dquadros/ch32v_piano/Imagens/Placa.png

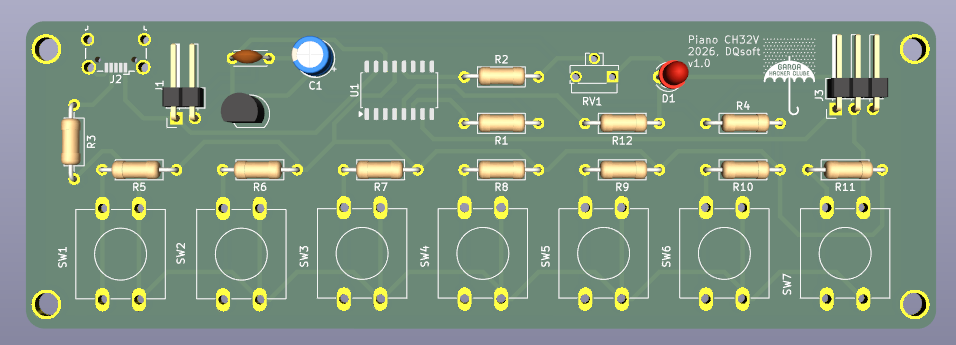
Imagens/Placa.png
