dquadros/ch32v_piano/hardware/PianoCH32V_sch.pdf

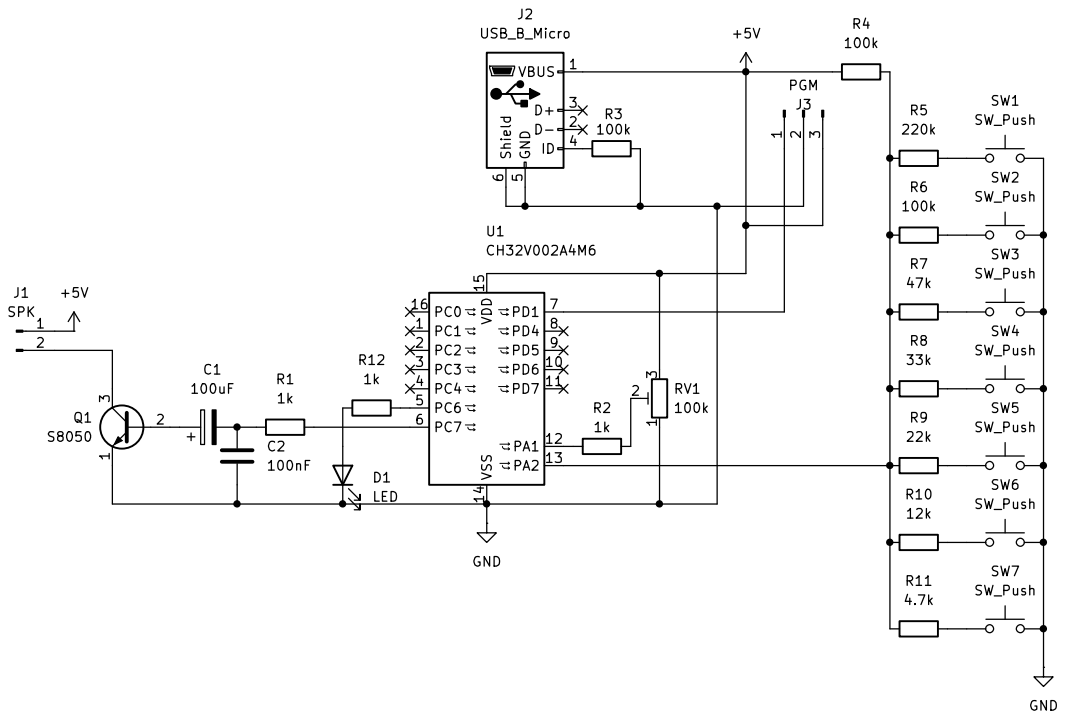
[picture p2: page 1]
