dquadros/ch32v_piano/hardware/PianoCH323V.kicad_pcb

## KiCad design hardware/PianoCH323V.kicad_pcb (2026-10-10)

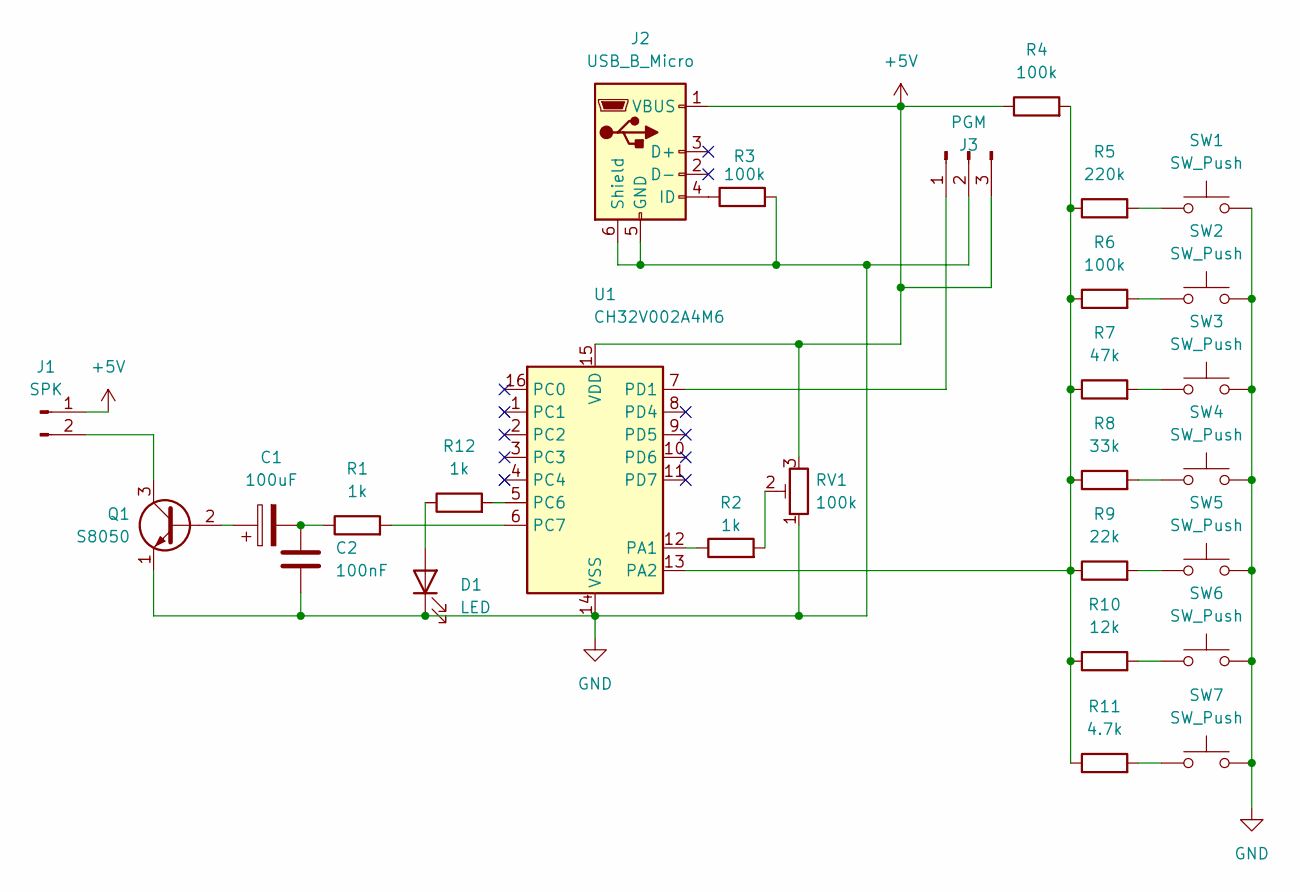
[picture p3: schematic PianoCH323V.kicad_sch]

Parts:
C1: 100uF; CP_Radial_D5.0mm_P2.50mm
C2: 100nF; C_Disc_D4.3mm_W1.9mm_P5.00mm
D1: LED; LED_D3.0mm
J1: SPK; PinHeader_1x02_P2.54mm_Horizontal
J2: USB_B_Micro; USB_Micro-B_Wuerth_629105150521_CircularHoles
J3: PGM; PinHeader_1x03_P2.54mm_Horizontal
Q1: S8050; TO-92_Inline
R1, R2, R12: 1k; R_Axial_DIN0207_L6.3mm_D2.5mm_P10.16mm_Horizontal
R3, R4, R6: 100k; R_Axial_DIN0207_L6.3mm_D2.5mm_P10.16mm_Horizontal
R5: 220k; R_Axial_DIN0207_L6.3mm_D2.5mm_P10.16mm_Horizontal
R7: 47k; R_Axial_DIN0207_L6.3mm_D2.5mm_P10.16mm_Horizontal
R8: 33k; R_Axial_DIN0207_L6.3mm_D2.5mm_P10.16mm_Horizontal
R9: 22k; R_Axial_DIN0207_L6.3mm_D2.5mm_P10.16mm_Horizontal
R10: 12k; R_Axial_DIN0207_L6.3mm_D2.5mm_P10.16mm_Horizontal
R11: 4.7k; R_Axial_DIN0207_L6.3mm_D2.5mm_P10.16mm_Horizontal
RV1: 100k; Potentiometer_Runtron_RM-063_Horizontal
SW1, SW2, SW3, SW4, SW5, SW6, SW7: SW_Push; SW_PUSH-12mm
U1: CH32V002A4M6; SOP-16_4.55x10.3mm_P1.27mm

Connections:
+5V: J1.1, J2.1 (VBUS), J3.3, R4.1, RV1.3, U1.15 (VDD)
GND: C2.2, D1.1 (K), J2.5 (GND), J2.6 (Shield), J3.2, Q1.1 (E), R3.2, RV1.1, SW1.2, SW2.2, SW3.2, SW4.2, SW5.2, SW6.2, SW7.2, U1.14 (VSS)
unnamed: C1.2, C2.1, R1.1
unnamed: D1.2 (A), R12.1
unnamed: J1.2, Q1.3 (C)
unnamed: J2.4 (ID), R3.1
unnamed: J3.1, U1.7 (PD1)
unnamed: C1.1, Q1.2 (B)
unnamed: R2.2, RV1.2
unnamed: R5.2, SW1.1
unnamed: R6.2, SW2.1
unnamed: R7.2, SW3.1
unnamed: R8.2, SW4.1
unnamed: R9.2, SW5.1
unnamed: R10.2, SW6.1
unnamed: R11.2, SW7.1
unnamed: R2.1, U1.12 (PA1)
unnamed: R4.2, R5.1, R6.1, R7.1, R8.1, R9.1, R10.1, R11.1, U1.13 (PA2)
unnamed: R12.2, U1.5 (PC6)
unnamed: R1.2, U1.6 (PC7)

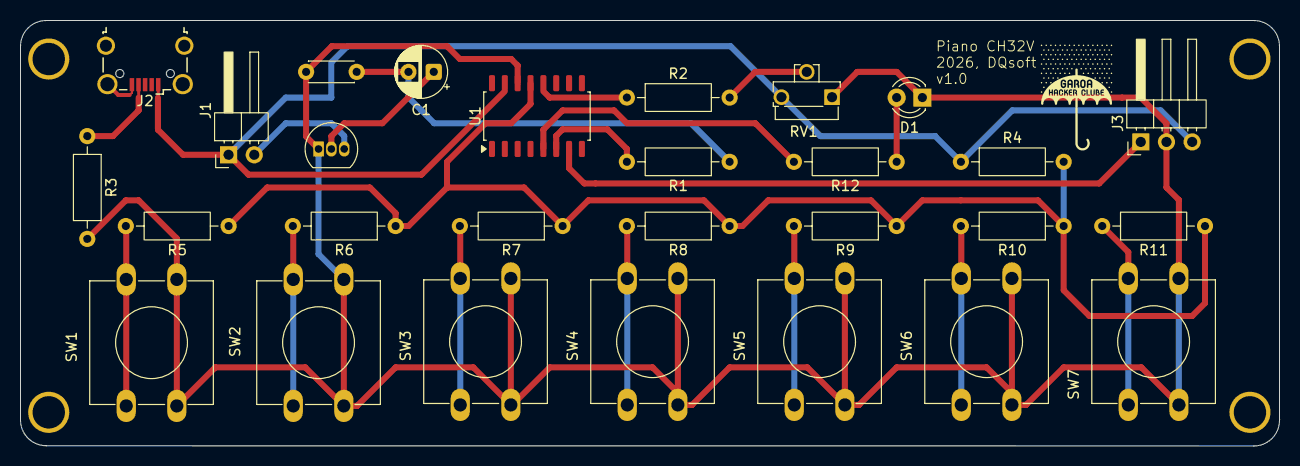
[picture p4: board PianoCH323V.kicad_pcb from above]

Board: 2 copper layers, 124.5 x 42.1 mm, 28 parts (0 on the bottom side), 20 nets.
